vincent42066/projetDev/projet_Elec/SF1D.pptx

Captage Distance

Conditionnement numérique

Traitement numériques

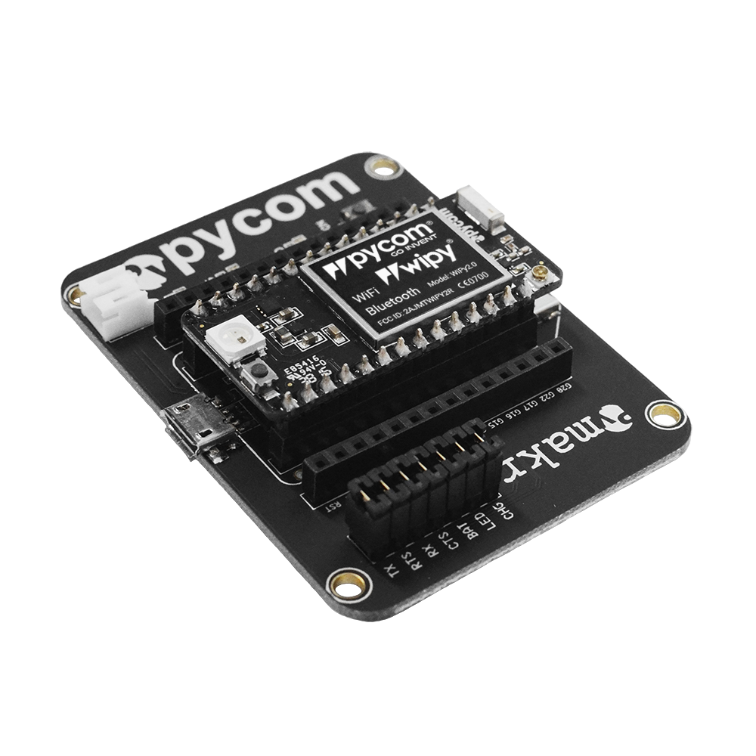
[picture p41: figure]
wipyExpansionSideN

Interfaçage I2C

Distance

Dist_Ana

Cpt_pres

SDA

SCL

FP4

ChampMagnétique1

Captage Vitesse rotation moteur

FP1

OUTB1

OUTA1

FP2

AIN2

AIN1

Commande en puissance

AOUT2

AOUT1

Moteurs

ChampMagnétique2

FP3

OUTB2

OUTA2

BIN1

BIN2

FP5

BOUT1

BOUT2

FP6

Energie

Alimentation

+3.3V

Signalisation présence alimentation

DAT0

SCLK

Stockage donnée

Valim

FA1

Interfaçage

Interfaçage

Info Visuelle

CMD

FP7

FA2

Gestion recharge batterie

Valim-recharge

FA3

FP8

FP9

FP8
