vincent42066/projetDev/projet_Elec/document_à_rendre/Cout_projet_final.xlsx

 | ORDRE D'ACHAT
Equipement | Lien | Prix Unit | Quantité | Prix Tot
Driver moteur CC compatible 3,7 V, I2C: | https://www.gotronic.fr/art-commande-de-2-moteurs-cc-rob-13911-25821.htm | 19.75 | 1 | 19.75
Moteur CC compatible 3,7(avec encodeur) : | https://www.robotshop.com/ca/fr/jeu-roues-moteurs-miniq-encodeurs.html | 38.67 | 1 | 38.67
Batterie Lipo 2000 mAh: | https://www.robotshop.com/ca/fr/batterie-lipo-37v-2000mah-5c.html | 9.4 | 1 | 9.4
Capteur luminosité 3,7V: | https://www.gotronic.fr/art-capteur-de-luminosite-tsl2561-19569.htm (2.7 à 3.6V) | 6.8 | 1 | 6.8 | Total | 179.2
µC: | https://fr.rs-online.com/web/p/adaptateurs-pour-reseau-sans-fil/1259531/?sra=pmpn | 34.31 | 1 | 34.31 | Budget | -59.2
interrupteur: | https://www.robotshop.com/eu/fr/mini-interrupteur-sfe.html | 1.26 | 1 | 1.26
Carte PCB (On est pas encore capable de faire le schéma): |  |  | 1 | 0
Carte SD | https://www.robotshop.com/eu/fr/carte-microsd-2-go.html | 8.38 | 1 | 8.38
Carte d'extension Pycom, Universal Expansion Board, pour LoPy, WiPy 2.0 | https://fr.rs-online.com/web/p/accessoires-pour-kit-de-developpement-pour-semi-conducteurs/1259534/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 | 23.39 | 1 | 23.39
Capteur IR compatible 3,7V: | https://www.robotshop.com/ca/fr/interface-pololu-capteur-distance-gp2y0d815z0f-ir-sharp-05-15-cm.html | 9.31 | 4 | 37.24
Multi pack Wipy 3.0 | https://pycom.io/product/wipy-3-0-multipack/ | 85 | 1 | 85
 |  |  |  |  |  | s
Driver explication moteur | https://learn.adafruit.com/adafruit-drv8833-dc-stepper-motor-driver-breakout-board/pinouts
Notice encodeur : | https://www.dfrobot.com/wiki/index.php/Mini_Robot_chassis_Encoder_(SKU:SEN0116)
Driver moteur CC compatible 3,7 V: | https://www.gotronic.fr/art-driver-moteur-pas-a-pas-ada3297-25543.htm |  |  | 5.8
chassis pour le robot avec moteur (sans encodeur): | https://www.gotronic.fr/art-chassis-turtle-2wd-19355.htm |  |  | 39.5
 | https://www.gotronic.fr/art-chassis-circulaire-3pi20-21026.htm |  |  | 45.5
