vincent42066/projetDev/projet_Elec/Robot_Python/Electronique/Nomenclature.xlsx

Nomenclature - Electronique
Carte électronique
Quantité | Réf schéma | Valeur | Réf fabricant
1 | R1 | 10 kohms | CR1206-FX-1200ELF
10 | R2-R11 | 330 Ohms | CR1206-FX-3300ELF
1 | Ctrl_Puissance |  | DSWPK_2
1 | RESET_BUTTON | NC | PBDP_ST
5 | Header 5 borches |  | HDR1X5
3 | Header 3 borches |  | HDR1X3
1 | Header 6 borches |  | HDR1X6
1 | Header 8 borches |  | HDR1X8
2 | Header 2 borches |  | HDR1X2
2 | Header 14 borches |  | HDR1X14
