vincent42066/projetDev/projet_Elec/Robot_Python/Electronique/Fichier Gerber/PCB_robot_ulti_1.dxf

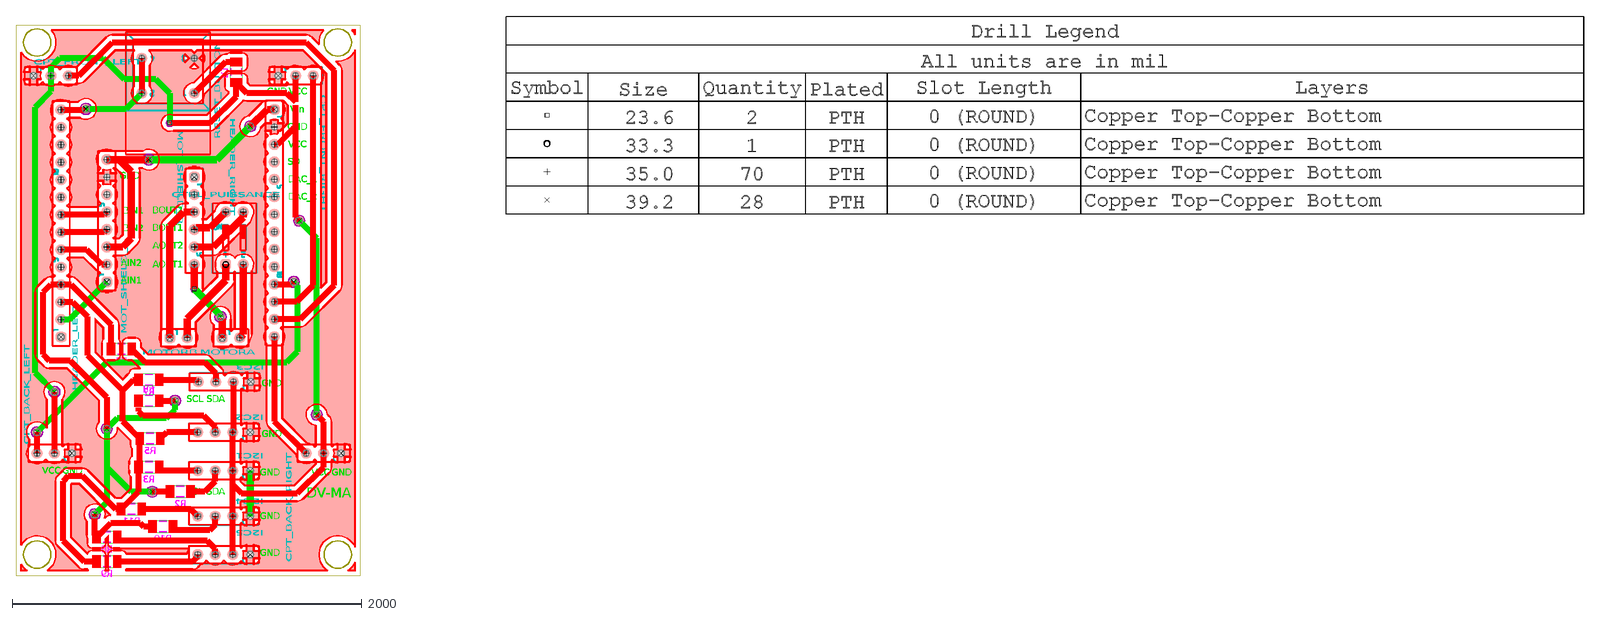
[picture p42: CAD file, 2018-07-06]
projet_Elec/Robot_Python/Electronique/Fichier Gerber/PCB_robot_ulti_1.dxf
I2C2
I2C3
CPT_BACK_RIGHT
CPT_BACK_LEFT
CPT_FRONT_LEFT
HEADER_LEFT
MOTORB
MOTORA
HEADER_RIGHT
MOT_SHIELD_L
CTRL_PUISSANCE
MOT_SHIELD_R
CPT_FRONT_RIGHT
RESET_BUTTON
I2C4
I2C1
I2C5
R1
R9
R8
R10
R3
R5
R4
R7
R6
R11
R2
DV-MA
GND
SCL
SDA
VCC
AIN1
AIN2
AOUT1
AOUT2
BIN2
BOUT1
BIN1
BOUT2
DAC_2
DAC_1
SD
Vin
