vincent42066/projetDev/projet_Elec/Robot_Python/Electronique/Images/PCB_robot_ulti_1 - 3D.igs

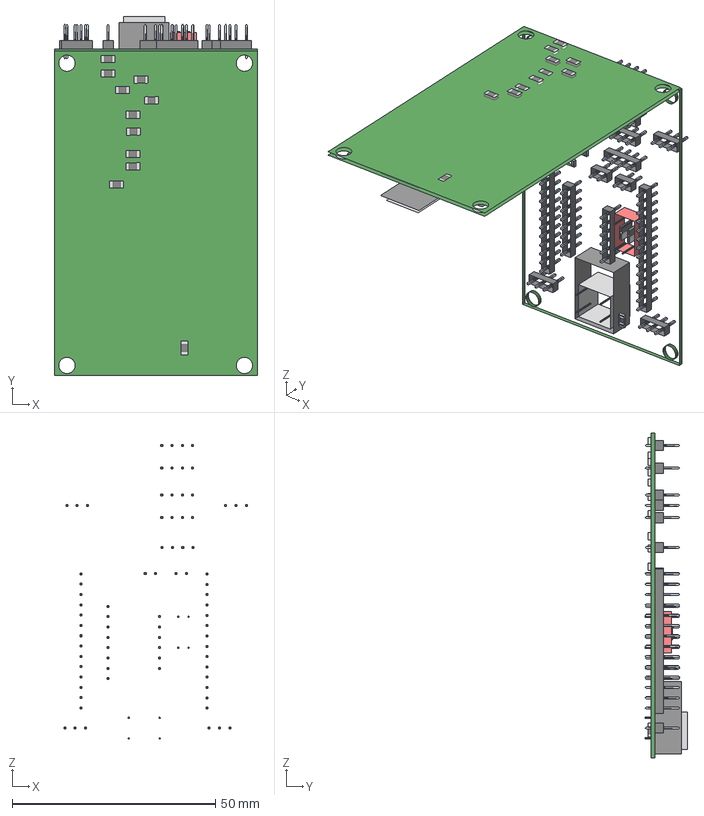
[picture p43: CAD file, 2018-07-06]
projet_Elec/Robot_Python/Electronique/Images/PCB_robot_ulti_1 - 3D.igs
50.0 x 88.5 x 81.3 mm
