vincent42066/projetDev/(list of files, cad)

Other CAD files:
projet_Elec/Robot_Python/Electronique/Images/PCB_robot_ulti_1 - 3D.dxf
