vincent42066/projetDev/(list of files, drawings)

Other design files:
projet_Elec/Robot_Python/Electronique/PCB_robot.ms14
