vincent42066/projetDev/(commit log)

2018-01-28 #Pinfo add tuto for I2C , UART, ADC
2018-02-27 #Pinfo new code not working because of wrong PWM Pinout
    [Exemple_Ardumoto.c, ardumoto.py]
2018-03-05 Add CDC, price of project and ardumoto
    [Cout_projet.xlsx]
2018-04-05 add useful link, improve document to send
    [Cout_projet.xlsx]
2018-07-06 code pour gérer les encoder
2018-07-06 Bon de commande
    [Bon de commande DESNOS MAURICE.xlsx]
2018-07-06 ajout cout de projet
    [Cout_projet_final.xlsx]
2018-07-06 ajout fichier gerber
    [PCB_robot_ulti_1 - Board Outline.gbr, PCB_robot_ulti_1 - Copper Bottom.gbr, PCB_robot_ulti_1 - Copper Top-Copper Bottom.drl, PCB_robot_ulti_1 - Copper Top.gbr, PCB_robot_ulti_1 - Drill-Copper Top-Copper Bottom.gbr, PCB_robot_ulti_1 - Silkscreen Bottom.gbr, PCB_robot_ulti_1 - Silkscreen Top.gbr, PCB_robot_ulti_1 - Solder Mask Bottom.gbr]
2018-07-06 ajout partie elec
    [Nomenclature.xlsx, PCB_robot.ms14, PCB_robot_ulti_1 - 3D.dxf, PCB_robot_ulti_1 - 3D.igs]
2018-07-06 ajout chassis decoupe laser
